safasalman/CAN-Mirror/README.md

CAN-Mirror
==========

The CAN Mirror is a one-way CAN traffic repeater. It reads traffic from CAN Bus A and repeats it on CAN Bus 2.
