safasalman/CAN-Mirror/Documentation/CAN Mirror BOM.xlsx

Mfg Part Num | Mfg Name | Qty-1 | VID | Vendor Part Num | Description | Type | Tolerance | Voltage Rating | Package | Value | Part References | Value
9-146274-0-20 | TE Connectivity | 1 | DK | A34259-20-ND | Header, Male pin, .1ﾔ 1-row, 20 pos, breakable | Connector | * | * | * | * | START_GND
9-146274-0-20 | TE Connectivity | 5 | DK | A34259-20-ND | Header, Male pin, .1ﾔ 1-row, 20 pos, breakable | Connector | * | * | * | * | AUX1_12VG, AUX1_NONC, AUX2_12VG, AUX2_NONC, MAIN_PRE_12
43045-0415 | Molex | 2 | NW | 56H9469 | Header, Microfit 4pos, SMD | Connector | * | * | * | * | IND, IND2
43650-0321 | Molex | 8 | NW | 34R5766 | Header, Microfit 3pos, SMD | Connector | * | * | * | * | AUX1, AUX2, AUX_BUS, HORN, MAIN, PRE, START_SW, STOP
HSMH-C190 | Avago | 2 | NW | 40K0127 | LED, Red, 0603, 17mcd | LED | * | * | 603 | RED | LED0, LED1
C1608X7R1E104K080AA | TDK | 3 | DK | 445-1316-1-ND | Capacitor, Ceramic, .1uF 25V 10% 0603 X7R | Capacitor | 10% | 25V | 603 | 0.1 uF | C6, C7, C10 | .1uf
CRCW06030000Z0EA | Vishay Dale | 4 | NW | 52K8014 | Resistor, 0 ohm, Jumper, 100 mW, 0603, 1% | Resistor | * | * | 603 | 0 ohm | R2, R6, R7, R8 | 0
GRM188R61E225KA12D | Murata | 6 | NW | 13T1193 | Capacitor, Ceramic, 2.2UF, 10%, 25V, 0603, X5R | Capacitor | 10% | 25V | 603 | 2.2 uF | C1, C16, C18, C19, C20, C21 | 2.2uf
RC0603FR-102K2L | Yageo | 6 | NW | 68R0123 | Resistor, 2.2k ohm, Thick Film, 100 mW, 1%, 0603 | Resistor | 1% | * | 603 | 2.2k ohm | R1, R5, R14, R15, R16, R17 | 2k2
ERJ-3EKF4701V | Panasonic | 1 | DK | P4.70KHCT-ND | Resistor, 4.7k ohm 1%, 100 mW, 100ppm, 0603 | Resistor | 1% | 50V | 603 | 4.7k ohm | R4 | 5k
C1608C0G1H080D080AA | TDK | 4 | DK | 445-5043-1-ND | Capacitor, Ceramic, 8pF, 50V, NP0, 0603 | Capacitor | +-.5pf | 50V | 603 | 8pF | C2, C3, C4, C5 | 8pf
ECS-100-8-30B-CKM | ECS Inc | 1 | DK | XC1835CT-ND | Crystal, 10MHz, 10ppm, 8pF load, 5x3SMD | Crystal | 10ppm | * | 5x3.2SMD | 10MHz | Y1 | 10MHz
T491A106M020AT | Kemet | 4 | DK | 399-5152-1-ND | Capacitor, Tantalum, 10uF 20V ,CT3216 | Capacitor | * | 20V | CT3216 | 10 uF | C8, C9, C13, C15 | 10uf
ECS-200-8-30B-CKM | ECS Inc | 1 | DK | XC1841CT-ND | Crystal, 20MHz, 10ppm, 8pF load, 5x3SMD | Crystal | 10ppm | * | 5x3.2SMD | 20MHz | Y2 | 20MHz
BKP1608HS600-T | Taiyo Yuden | 1 | DK | 587-1928-1-ND | Inductor, Chip, 60ohm, 1.5A, 0603 | Inductor | * | * | 603 | 60 ohm | L1 | 60ohm 1.5A ferrite
RC0805FR-07120RL | Yageo | 1 | DK | 311-120CRCT-ND | Resistor, 120 ohm 125 mW, 5%, Thick Film 0805 | Resistor | 5% | * | 805 | 120 ohm | R10 | 120
MH1608-221Y | Bourns Inc | 1 | DK | MH1608-221YDKR-ND | Inductor, Chip, 220ohm, 0603 | Inductor | * | * | 603 | 220 ohm | L2 | 220ohm ferrite
ERJ-3GEYJ301V | Panasonic | 2 | DK | P300GCT-ND | Resistor, 300 ohm, 5% 0603 | Resistor | 5% | * | 603 | 300 ohm | R3, R18 | 300
776262-1 | TE Connectivity | 2 | DK | A106462-ND | AmpSeal 14-pin vertical header | Connector | * | * | * | * | CANA_THROTTLE, SW_IND | AMPSEAL_14_7762XX
1-776276-1 | TE Connectivity | 2 | DK | A106572-ND | AmpSeal 8-pin vertical header | Connector | * | * | * | * | U$13, U$14 | CANBUS2VERT
IM26GR | TE Connectivity | 1 | DK | PB1166CT-ND | Relay, IM Telecom, DPDT, 12V coil, SMT 2FormC | Relay | * | 12V | 2 form C | * | U8 | CAN_Term
MBR0540T1G | ON Semiconductor | 4 | DK | MBR0540T1GOSCT-ND | Diode, Schottky, 40V 0.5A SOD-123 | Diode | * | 40V | SOD-123 | * | D1, D3, D4, D5 | DIODE
MCP2515-I/SO | Microchip | 1 | DK | MCP2515-I/SO-ND | IC, CAN Controller. SPI interface, SOIC-18 | ICs, Communication | * | * | SOIC-18 | * | U4 | MCP2515
R-78C3.3-1.0 | Recom | 1 | DK | 945-1394-5-ND | DC-DC Converter, 1A, 9-42V input, 3.3V output, Non-Isolated, 78xx replacement | DC/DC | * | 3.3V | SIP3 | 1A | U1 | RECOM_DCDC3v3
R-78C5.0-1.0 | Recom | 1 | DK | 945-1395-5-ND | DC-DC Converter, 1A, 9-42V input, 5V output, Non-Isolated, 7805 replacement | DC/DC | * | 5V | SIP3 | 1A | U2 | RECOM_DCDC5v
534237-4 | TE Connectivity | 1 | DK | A26418-ND | Header, Female socket, .1ﾔ 1-row, 6-pos | Connector | * | * | * | * | RIDER_CONTROLS | RIDER_CONTROLS
534237-4 | TE Connectivity | 1 | DK | A26418-ND | Header, Female socket, .1ﾔ 1-row, 6-pos | Connector | * | * | * | * | RIDER_DISPLAY | RIDER_DISPLAY
SN65HVD230D | Texas Instruments | 2 | NW | 75C7744 | IC, CAN Transceiver, 3.3V, with Standby, SOIC-8 | ICs, Communication | * | * | SOIC-8 | * | U5, U6 | SN65HVD230
SN74LVC2G07DBVR | Texas Instruments | 1 | DK | 296-13494-1-ND | IC, Buffer, 2-bit, non-invert, open drain, SOT-23-6 | ICs, Logic | * | * | SOT-23-6 | * | U7 | SN74LVC2G07DBV
RS-187R05A2-DS MT RT | C&K Components | 2 | DK | CKN10361CT-ND | Switch, Tactile, 5.2x5.2mm SMD | Switch | * | * | * | * | BTN, RESET | SWITCH-MOMENTARY-2SMD
67996-114HLF | FCI | 1 | NW | 30M1973 | 0.1" Male Header - 2 rows, 14 positions (TI JTAG) - Through Hole, Vertical | Connector | * | * | * | * | U$6 | TI_JTAG14
TMS320F28035PNT | Texas Instruments | 1 | DK | 296-32764-ND | IC, MCU, C2000 piccolo, LQFP80 | ICs, MCU | * | * | LQFP-80 | * | U3 | TMS320F28034PNT
