safasalman/CAN-Mirror/Documentation/CAN Mirror schematic.pdf

# Sheet 1/4

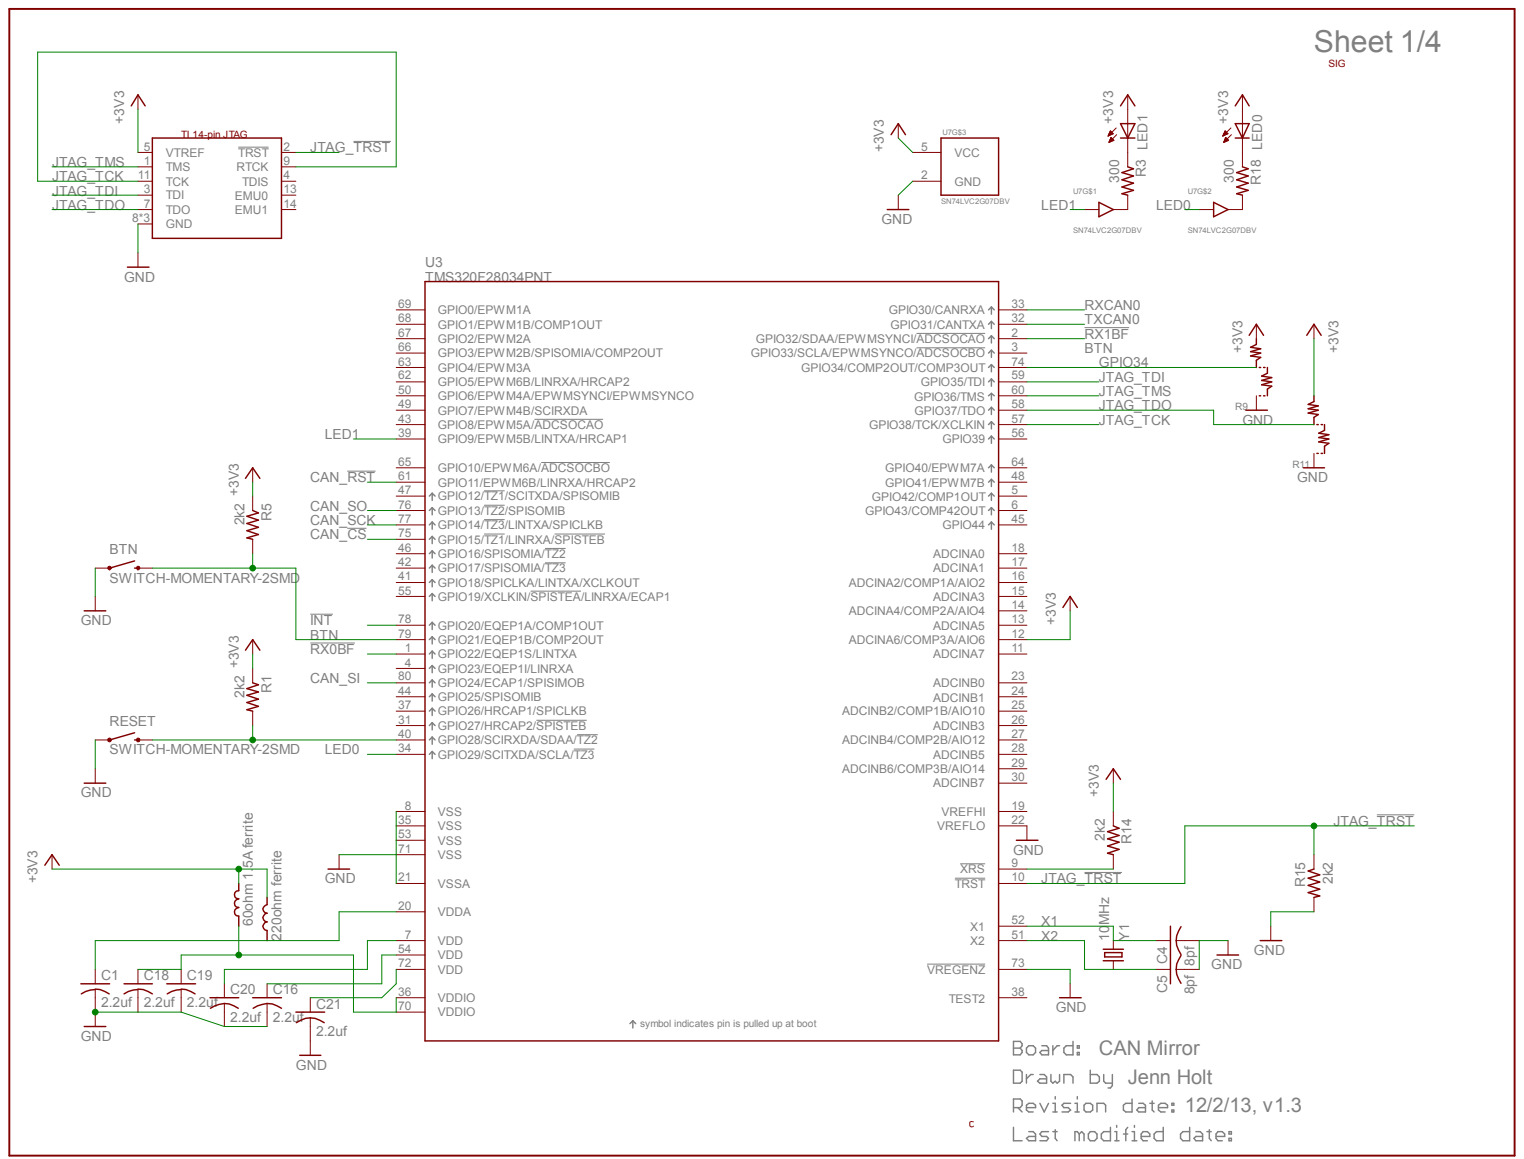
[picture p1: page 1]

symbol indicates pin is pulled up at boot

# Switches and Indicators (microfit headers)

# AmpSeal external connectors

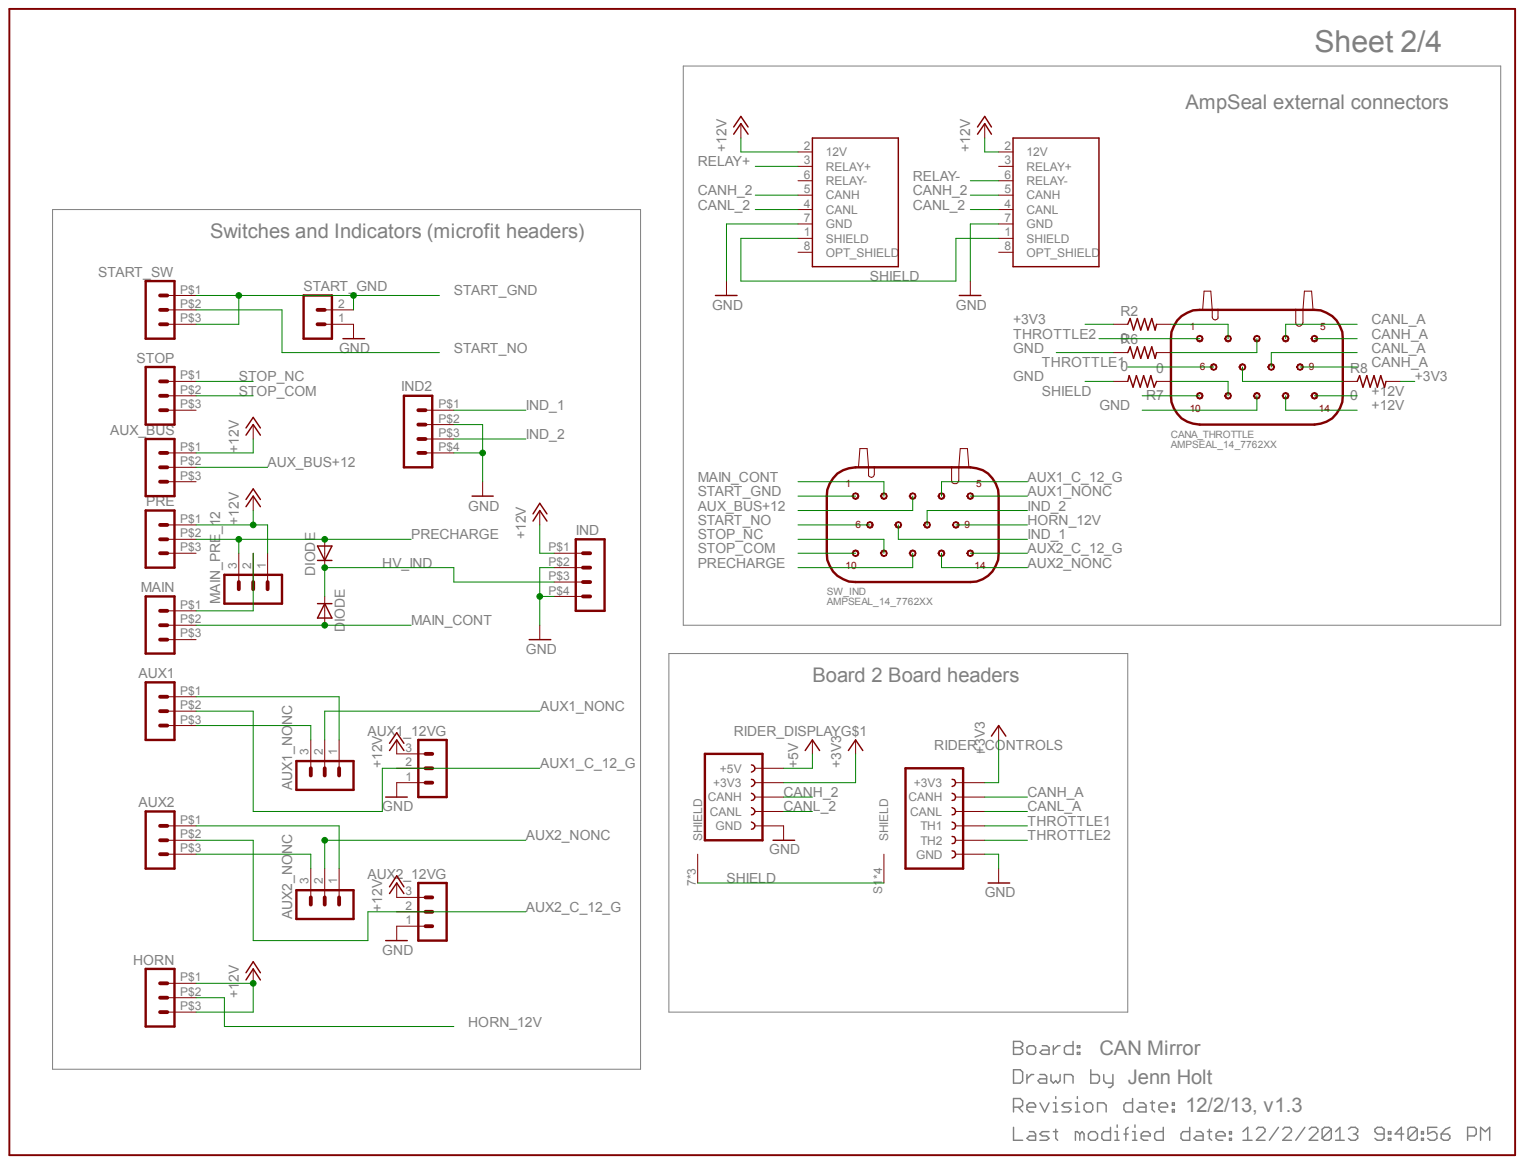
[picture p2: page 2]
CAN Mirror; Sheet 2/4; GND; GND⁺⁵V; DIODE; IND; START_SW; AUX1; AUX2; HORN; IND2; AUX1_NONC; AUX2_NONC; AUX2_12VG; AUX1_12VG; START_GND; MAIN_PRE_12; SW_IND AMPSEAL_14_7762XX; CANA_THROTTLE AMPSEAL_14_7762XX; 12V 2 RELAY+ 3 RELAY- 6 CANH 5 CANL 4 GND 7 SHIELD 1 OPT_SHIELD 8; STOP; AUX_BUS; PRE; MAIN; RIDER_DISPLAYG$1; CANL; CANH; SHIELD 7*3; RIDER_CONTROLS; SHIELD; START_NO; STOP_COM; STOP_NC; AUX_BUS+12; PRECHARGE; MAIN_CONT; HV_IND; AUX1_C_12_G; AUX2_C_12_G; HORN_12V; IND_1; IND_2; CANH_2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

Board 2 Board headers

# Sheet 3/4

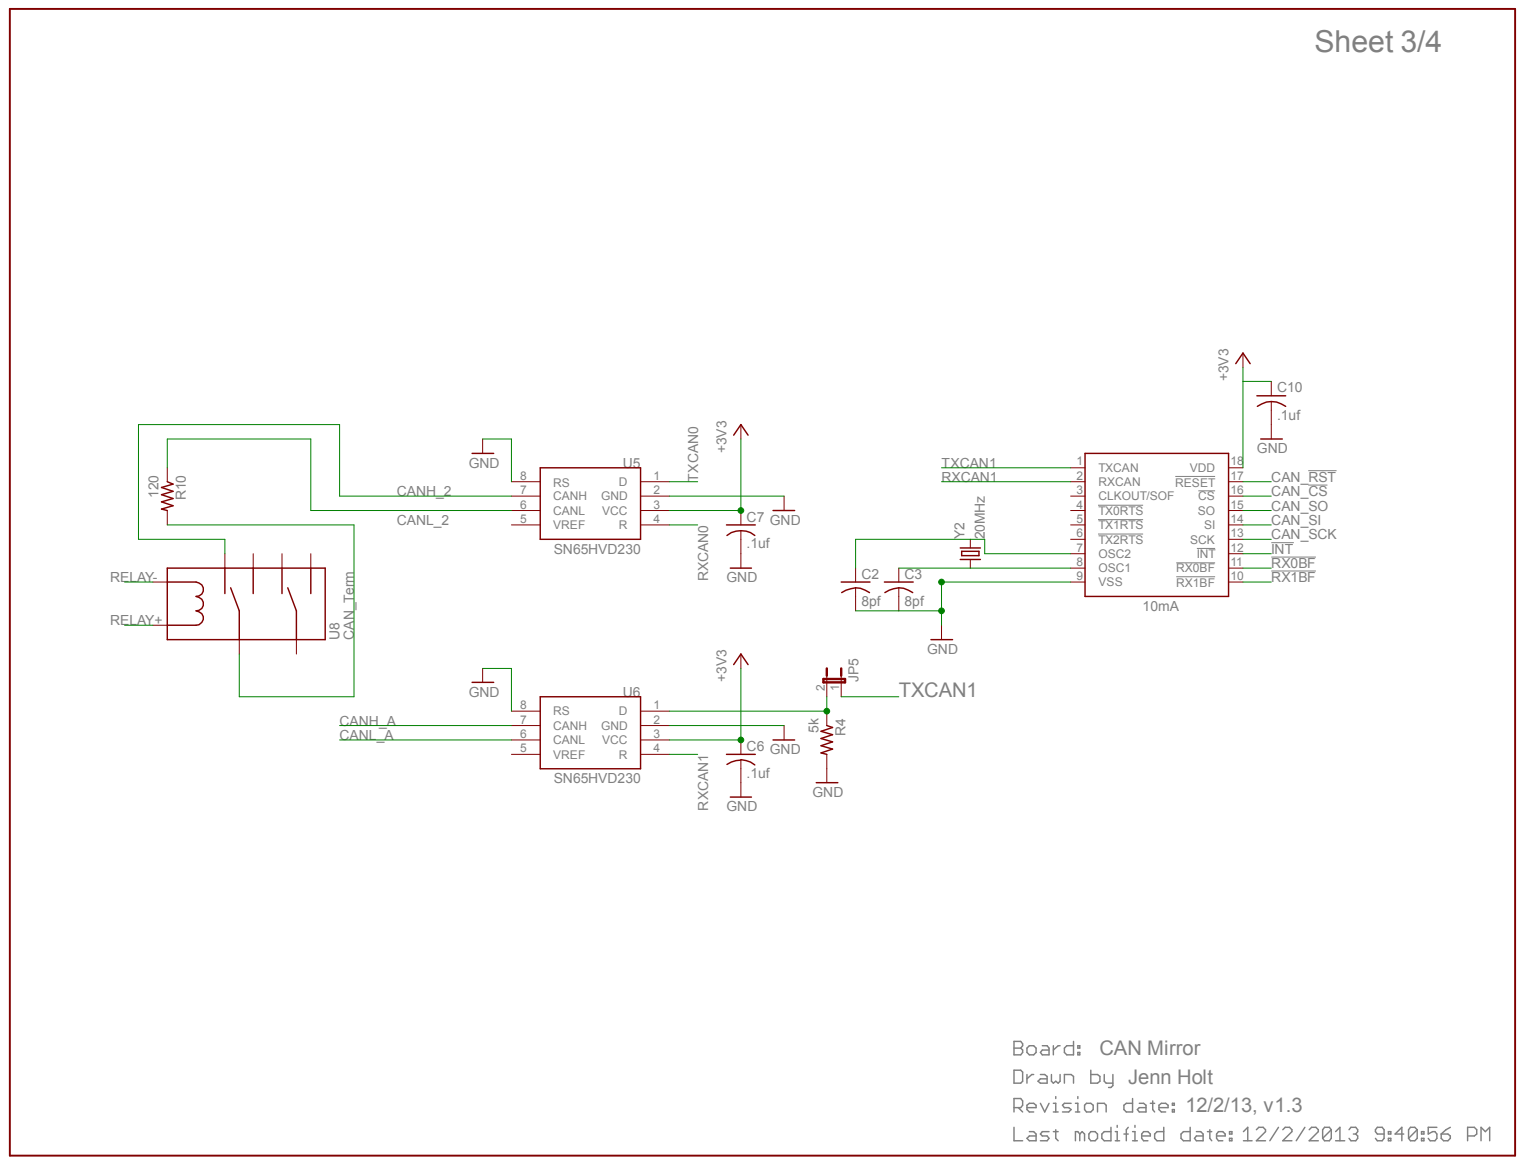
[picture p3: page 3]

# Sheet 4/4

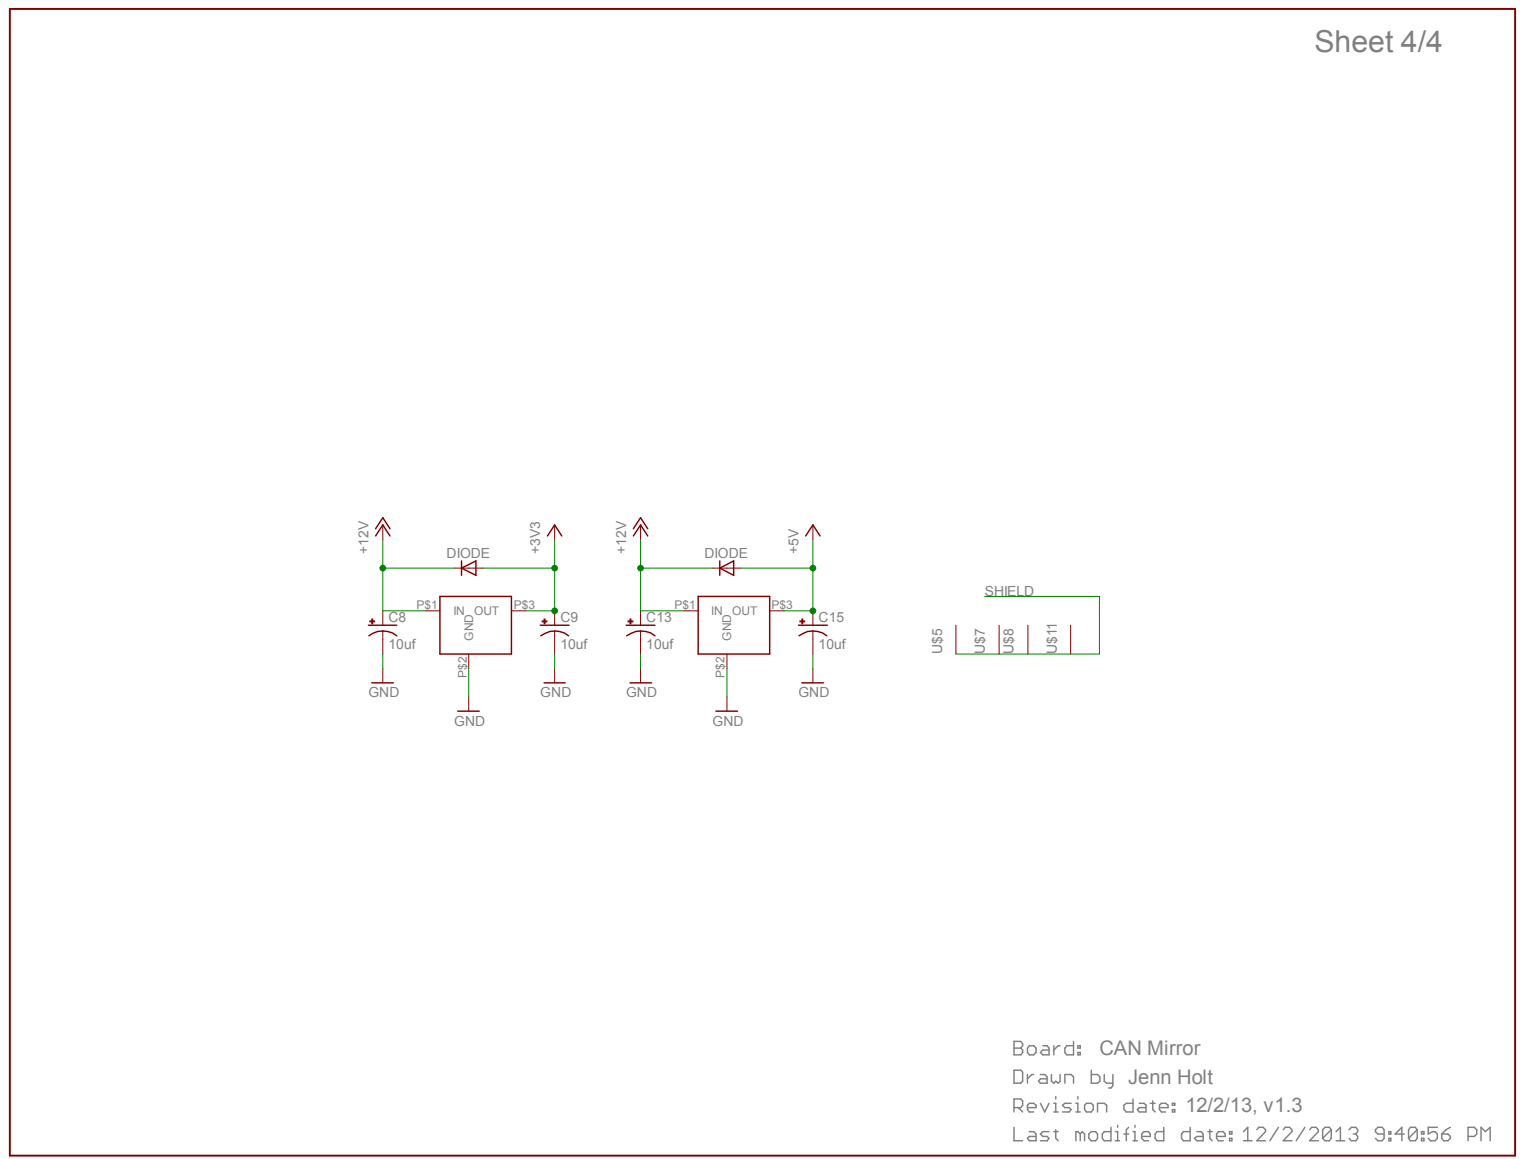
[picture p4: page 4]
CAN Mirror; GND; DIODE; OUT; P$3 GND P$2; SHIELD
