safasalman/CAN-Mirror/Documentation/CAN Mirror bottom.pdf

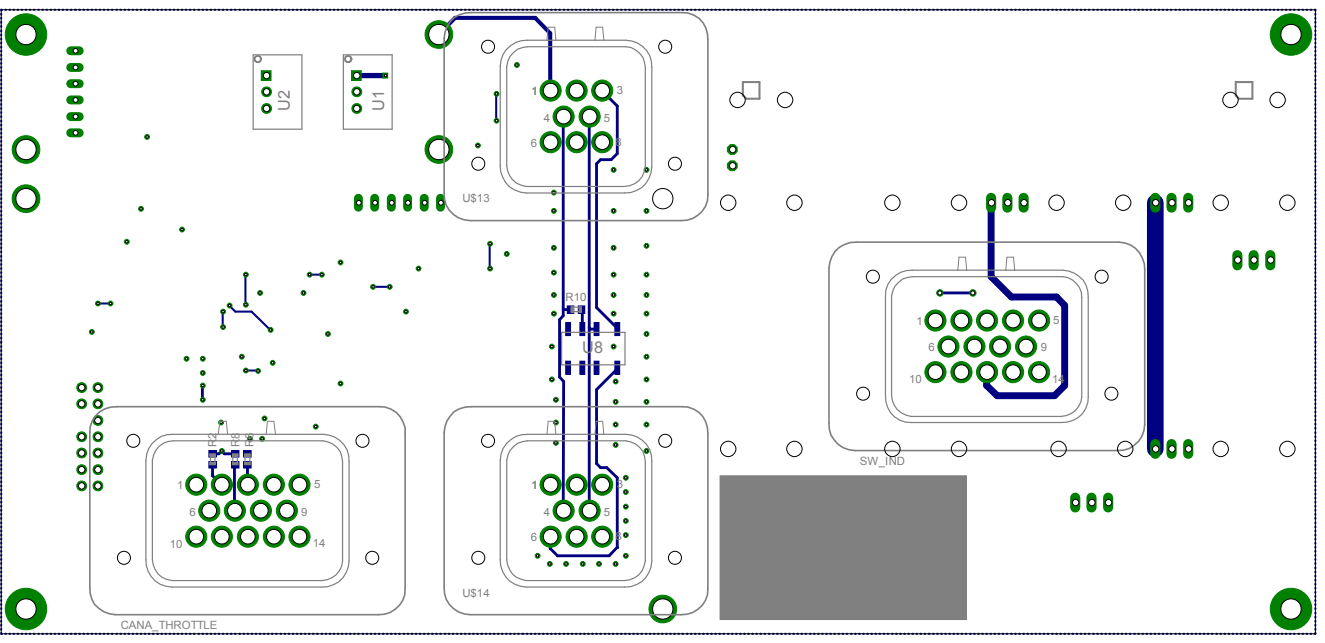
[picture p6: page 1]
SW_IND; CANA_THROTTLE
