safasalman/CAN-Mirror/Documentation/CAN Mirror top.pdf

# RESET R¹

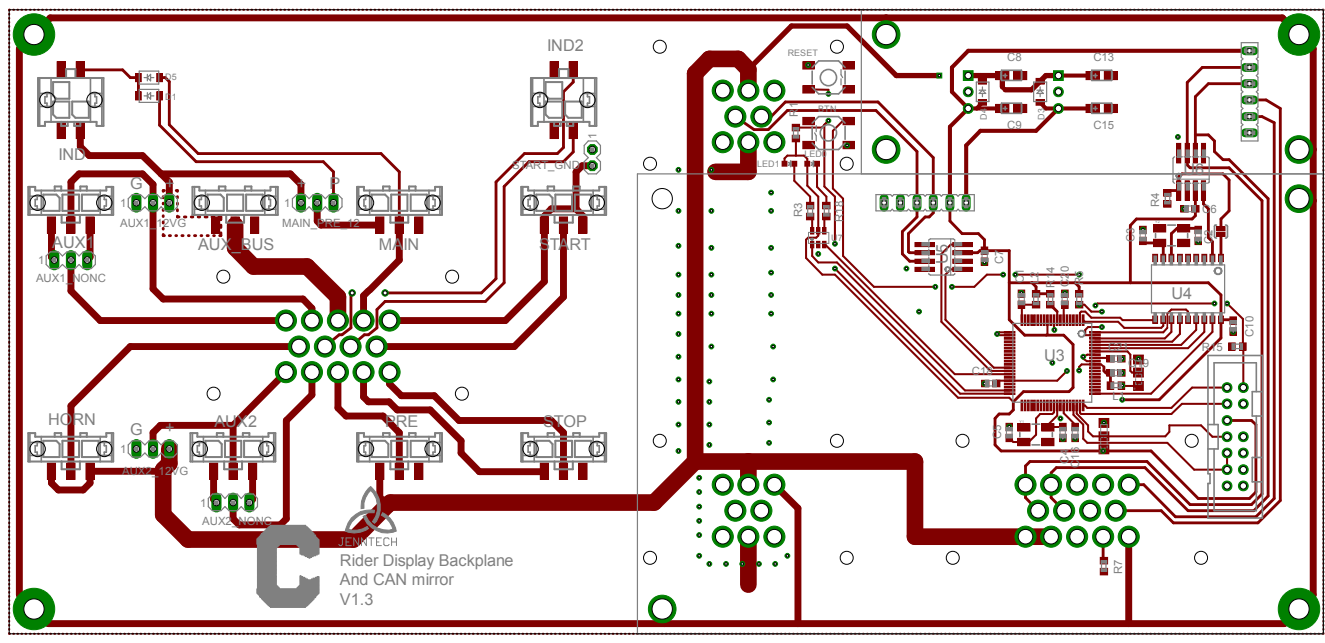
[picture p7: page 1]
