safasalman/CAN-Mirror/(commit log)

2014-11-10 Bring version 1.3 into source control.
    [CAN Mirror BOM.xlsx, CAN Mirror.brd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]
2014-11-19 New CAN mirror files
    [CAN Mirror.brd, CAN Mirror.sch]
2014-11-24 Can Mirror schematic - incomplete
    [CAN Mirror.sch]
